bhusang/kicad_footprints/OLIMEX/KiCAD/KiCAD_Footprints/OLIMEX_3Dmodels/rubber_feet.SLDPRT

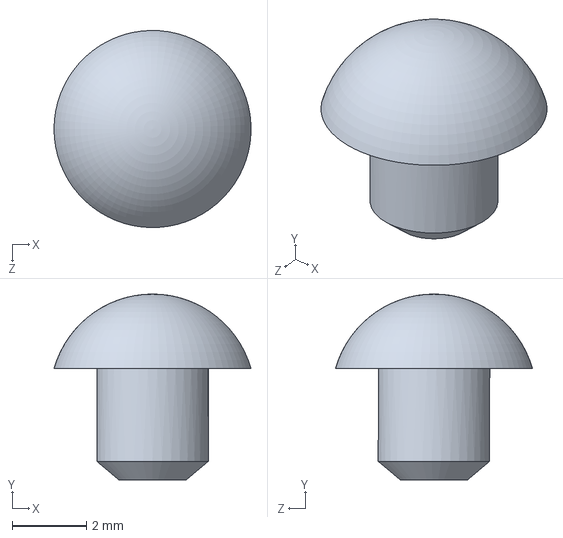
[picture p1: CAD file, 2022-04-01]
OLIMEX/KiCAD/KiCAD_Footprints/OLIMEX_3Dmodels/rubber_feet.SLDPRT
5.30 x 5.00 x 5.30 mm
