bhusang/kicad_footprints/OLIMEX/KiCAD/KiCAD_Footprints/OLIMEX_3Dmodels/User Library-BU2032SM-HD-G(CR2032 Battery Holder).SLDPRT

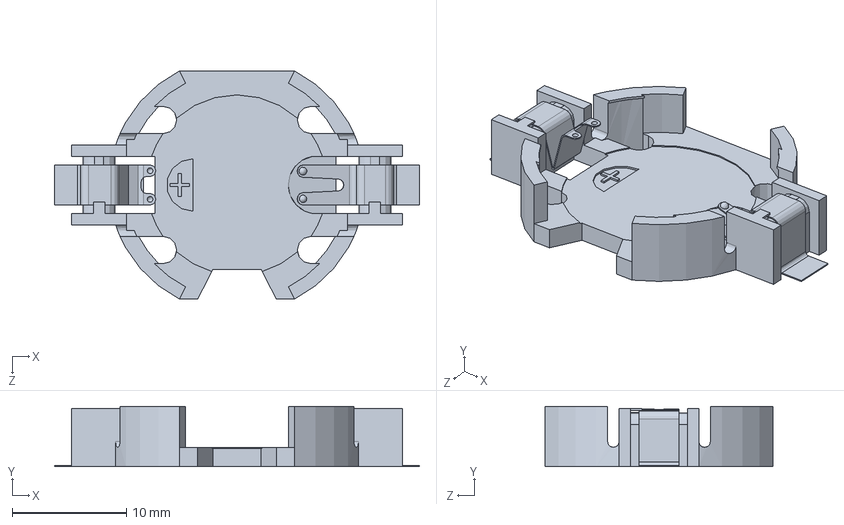
[picture p2: CAD file, 2022-04-01]
OLIMEX/KiCAD/KiCAD_Footprints/OLIMEX_3Dmodels/User Library-BU2032SM-HD-G(CR2032 Battery Holder).SLDPRT
32.0 x 5.30 x 20.0 mm
