bhusang/kicad_footprints/adamgreig/agg-kicad/mod/ic/htqfp-64.yaml

description: HTQFP-64 (LQFP-64 with Exposed PowerPAD)
name: HTQFP-64
rows: 4
pins: 64
pin_pitch: 0.5
row_pitch: 11.4
pad_shape: [1.5, 0.3]
chip_shape: [10.2, 10.2]
pin_shape: [1.0, 0.27]
ep_shape: [8, 8]
ep_paste_shape: [7, 7, 0, 0]
ep_mask_shape: [7, 7, 0, 0]
ep_vais: [0.3, 0.6, 1.3]
model:
  offset: [0, 0, 0]
  rotate: [0, 0, 0]
  scale: [1, 1, 1]
  path: "${KISYS3DMOD}/Housings_QFP.3dshapes/LQFP-64_10x10mm_Pitch0.5mm.wrl"
