bhusang/kicad_footprints/adamgreig/agg-kicad/mod/ic/lattice-sg48.yaml

chip_shape: [7, 7]
description: QFN-48 from Lattice iCE40UP5K SG48
ep_mask_shape: [0.8, 0.8, 0.6, 0.6]
ep_paste_shape: [0.8, 0.8, 0.6, 0.6]
ep_shape: [5.4, 5.4]
ep_vias: [0.4, 0.8, 0.8]
model:
  offset: [0, 0, 0]
  path: ${KISYS3DMOD}/Housings_DFN_QFN.3dshapes/QFN-48-1EP_7x7mm_P0.5mm_EP5.15x5.15mm.step
  rotate: [0, 0, 0]
  scale: [1, 1, 1]
name: Lattice-SG48
pad_shape: [0.7, 0.25]
pin_pitch: 0.5
pin_shape: [-0.4, 0.25]
pins: 48
row_pitch: 6.8
rows: 4
