bhusang/kicad_footprints/adamgreig/agg-kicad/mod/ic/lqfp-100.yaml

chip_shape: [14.2, 14.2]
description: |-
  LQFP-100 from JEDEC MS-026BED
  IPC-7351B: QFP50P1600X1600X160-100N
model:
  offset: [0, 0, 0]
  path: ${KISYS3DMOD}/Housings_QFP.3dshapes/LQFP-100_14x14mm_Pitch0.5mm.wrl
  rotate: [0, 0, 0]
  scale: [1, 1, 1]
name: LQFP-100
pad_shape: [1.5, 0.3]
pin_pitch: 0.5
pin_shape: [1.0, 0.27]
pins: 100
row_pitch: 15.4
rows: 4
