bhusang/kicad_footprints/adamgreig/agg-kicad/mod/ic/lqfp-144.yaml

chip_shape: [20.2, 20.2]
description: |-
  LQFP-144 from JEDEC MS-026BFB
  IPC-7351B: QFP50P2200X2200X160-144N
model:
  offset: [0, 0, 0]
  path: ${KISYS3DMOD}/Housings_QFP.3dshapes/LQFP-144_20x20mm_Pitch0.5mm.wrl
  rotate: [0, 0, 0]
  scale: [1, 1, 1]
name: LQFP-144
pad_shape: [1.5, 0.3]
pin_pitch: 0.5
pin_shape: [1.0, 0.27]
pins: 144
row_pitch: 21.4
rows: 4
