bhusang/kicad_footprints/adamgreig/agg-kicad/mod/ic/lqfp-32.yaml

chip_shape: [7.2, 7.2]
description: LQFP-32 from JEDEC MS-026BBA
model:
  offset: [0, 0, 0]
  path: ${KISYS3DMOD}/Housings_QFP.3dshapes/LQFP-32_7x7mm_Pitch0.8mm.wrl
  rotate: [0, 0, 0]
  scale: [1, 1, 1]
name: LQFP-32
pad_shape: [1.2, 0.5]
pin_pitch: 0.8
pin_shape: [1.0, 0.4]
pins: 32
row_pitch: 8.4
rows: 4
