bhusang/kicad_footprints/adamgreig/agg-kicad/mod/ic/lqfp-64.yaml

chip_shape: [10.2, 10.2]
description: |-
  LQFP-64 from JEDEC MS-026BCD
  IPC-7351B: QFP50P1200X1200X160-64N
model:
  offset: [0, 0, 0]
  path: ${KISYS3DMOD}/Housings_QFP.3dshapes/LQFP-64_10x10mm_Pitch0.5mm.wrl
  rotate: [0, 0, 0]
  scale: [1, 1, 1]
name: LQFP-64
pad_shape: [1.5, 0.3]
pin_pitch: 0.5
pin_shape: [1.0, 0.27]
pins: 64
row_pitch: 11.4
rows: 4
