bhusang/kicad_footprints/adamgreig/agg-kicad/mod/ic/msop-10-ep-ti.yaml

chip_shape: [3.0, 3.0]
description: |-
  MSOP-10 with 0.5mm pin pitch and an EP, TI specific
  For the TPS92512, from its datasheet
  JEDEC MO-187BA-T
  IPC-7351B: SOP50P490X110-11N
ep_mask_shape: [1.83, 1.89, 0, 0]
ep_paste_shape: [1.83, 1.89, 0, 0]
ep_shape: [2.2, 3.1]
ep_vias: [0.3, 0.5, 0.3]
model:
  offset: [0, 0, 0]
  path: ${KISYS3DMOD}/Housings_SSOP.3dshapes/MSOP-10-1EP_3x3mm_Pitch0.5mm.wrl
  rotate: [0, 0, 0]
  scale: [1, 1, 1]
name: MSOP-10-EP-TI
pad_shape: [1.45, 0.3]
pin_pitch: 0.5
pin_shape: [0.95, 0.22]
pins: 10
row_pitch: 4.4
rows: 2
