bhusang/kicad_footprints/adamgreig/agg-kicad/mod/ic/msop-10.yaml

chip_shape: [3.0, 3.0]
description: |-
  MSOP-10 with 0.5mm pin pitch
  JEDEC MO-187
  IPC-7351B: SOP50P490X110-10N
model:
  offset: [0, 0, 0]
  path: ${KISYS3DMOD}/Housings_SSOP.3dshapes/MSOP-10_3x3mm_Pitch0.5mm.wrl
  rotate: [0, 0, 0]
  scale: [1, 1, 1]
name: MSOP-10
pad_shape: [1.45, 0.3]
pin_pitch: 0.5
pin_shape: [0.95, 0.25]
pins: 10
row_pitch: 4.4
rows: 2
