bhusang/kicad_footprints/adamgreig/agg-kicad/mod/ic/qfn-16-ep-ti.yaml

chip_shape: [3.0, 3.0]
description: |-
  VQFN-16 from TPS6215
  IPC-7351B: QFN26P300X300X100-17N
ep_paste_shape: [1.5, 1.5, 0.2, 0.2]
ep_shape: [1.7, 1.7]
ep_vias: [0.2, 0.3, 0.9]
model:
  offset: [0, 0, 0]
  path: ${KISYS3DMOD}/Housings_DFN_QFN.3dshapes/QFN-16-1EP_3x3mm_Pitch0.5mm.wrl
  rotate: [0, 0, 0]
  scale: [1, 1, 1]
name: QFN-16-EP-TI
pad_shape: [0.6, 0.25]
pin_pitch: 0.5
pin_shape: [-0.4, 0.25]
pins: 16
row_pitch: 2.8
rows: 4
