bhusang/kicad_footprints/adamgreig/agg-kicad/mod/ic/qfn-20-ep-si3402-b.yaml

chip_shape: [5.0, 5.0]
description: |-
  QFN-20 from JEDEC MO-220VHHB-1
  For Si3402-B
  IPC-7351B: QFN80P500X500X85-21N
ep_paste_shape: [1.1, 1.1, 0.2, 0.2]
ep_shape: [2.75, 2.75]
model:
  offset: [0, 0, 0]
  path: ${KISYS3DMOD}/Housings_DFN_QFN.3dshapes/QFN-20-1EP_5x5mm_Pitch0.65mm.wrl
  rotate: [0, 0, 0]
  scale: [1, 1, 1]
name: QFN-20-EP-SI3402-B
pad_shape: [0.95, 0.3]
pin_pitch: 0.8
pin_shape: [-0.55, 0.3]
pins: 20
row_pitch: 4.7
rows: 4
