bhusang/kicad_footprints/adamgreig/agg-kicad/mod/ic/qfn-64-ep-ltc-up.yaml

chip_shape: [9.0, 9.0]
description: |-
  QFN-64 from LTC2975 datasheet
  IPC-7351B: QFN50P900X900X75-64N
ep_mask_shape: [0.7, 0.7, 0.6, 0.6]
ep_paste_shape: [0.7, 0.7, 0.6, 0.6]
ep_shape: [7.15, 7.15]
ep_vias: [0.4, 0.8, 0.47]
model:
  offset: [0, 0, 0]
  path: ${KISYS3DMOD}/Housings_DFN_QFN.3dshapes/QFN-64-1EP_9x9mm_Pitch0.5mm.wrl
  rotate: [0, 0, 0]
  scale: [1, 1, 1]
name: QFN-64-EP-LTC-UP
pad_shape: [0.7, 0.25]
pin_pitch: 0.5
pin_shape: [-0.4, 0.25]
pins: 64
row_pitch: 8.8
rows: 4
