bhusang/kicad_footprints/adamgreig/agg-kicad/mod/ic/sc-70-5.yaml

chip_shape: [1.4, 2.15]
description: |-
  SC-70-5
  JEDEC MO-203-AA
  IPC-7351B: SOT65P210X110-5N
model:
  offset: [0, 0, 0]
  path: ${KISYS3DMOD}/TO_SOT_Packages_SMD.3dshapes/SC-70-5.wrl
  rotate: [0, 0, 90]
  scale: [1, 1, 1]
name: SC-70-5
pad_shape: [0.95, 0.4]
pin_pitch: 0.65
pin_shape: [0.5, 0.3]
pins: 6
row_pitch: 2.2
rows: 2
skip_pins: [5]
