bhusang/kicad_footprints/adamgreig/agg-kicad/mod/ic/sot-23-5.yaml

chip_shape: [1.7, 3.0]
description: |-
  SOT-23-5
  JEDEC MO-178
  IPC-7351B: SOT95P280X135-5N
model:
  offset: [0, 0, 0]
  path: ${KISYS3DMOD}/TO_SOT_Packages_SMD.3dshapes/SOT-23-5.wrl
  rotate: [0, 0, 0]
  scale: [1, 1, 1]
name: SOT-23-5
pad_shape: [1.1, 0.6]
pin_pitch: 0.95
pin_shape: [0.75, 0.5]
pins: 6
row_pitch: 2.6
rows: 2
skip_pins: [5]
