bhusang/kicad_footprints/adamgreig/agg-kicad/mod/ic/sot-23-6.yaml

chip_shape: [1.75, 3.05]
description: |-
  SOT-23-6
  JEDEC MO-178AB
  IPC-7351B: SOT95P280X145-6N
model:
  offset: [0, 0, 0]
  path: ${KISYS3DMOD}/TO_SOT_Packages_SMD.3dshapes/SOT-23-6.wrl
  rotate: [0, 0, 0]
  scale: [1, 1, 1]
name: SOT-23-6
pad_shape: [1.1, 0.6]
pin_pitch: 0.95
pin_shape: [0.62, 0.5]
pins: 6
row_pitch: 2.6
rows: 2
