bhusang/kicad_footprints/adamgreig/agg-kicad/mod/ic/ssop-20.yaml

chip_shape: [5.6, 7.2]
description: |-
  SSOP-20 from JEDEC MO-150AE
  IPC-7351B: SOP65P780X200-20N
model:
  offset: [0, 0, 0]
  path: ${KISYS3DMOD}/Housings_SSOP.3dshapes/SSOP-20_5.3x7.2mm_Pitch0.65mm.wrl
  rotate: [0, 0, 0]
  scale: [1, 1, 1]
name: SSOP-20
pad_shape: [1.85, 0.45]
pin_pitch: 0.65
pin_shape: [1.3, 0.38]
pins: 20
row_pitch: 7.0
rows: 2
