bhusang/kicad_footprints/adamgreig/agg-kicad/mod/ic/tssop-16.yaml

chip_shape: [4.5, 5.1]
description: |-
  TSSOP-16 from JEDEC MO-153AB
  IPC-7351B: SOP65P500X120-16N
model:
  offset: [0, 0, 0]
  path: ${KISYS3DMOD}/Housings_SSOP.3dshapes/TSSOP-16_4.4x5mm_Pitch0.65mm.wrl
  rotate: [0, 0, 0]
  scale: [1, 1, 1]
name: TSSOP-16
pad_shape: [1.35, 0.45]
pin_pitch: 0.65
pin_shape: [0.95, 0.3]
pins: 16
row_pitch: 5.75
rows: 2
