bhusang/kicad_footprints/adamgreig/agg-kicad/mod/ic/ufdfn-8.yaml

chip_shape: [3.0, 2.0]
description: |-
  UFDFN-8 / USON-8 from JEDEC MO-220
  AKA Winbond UX
model:
  offset: [0, 0, 0]
  path: ${KISYS3DMOD}/Package_DFN_QFN.3dshapes/DFN-8-1EP_3x2mm_P0.5mm_EP1.75x1.45mm.step
  rotate: [0, 0, 0]
  scale: [1, 1, 1]
name: UFDFN-8
pad_shape: [0.3, 0.25]
pin_pitch: 0.5
pin_shape: [-0.45, 0.25]
pins: 8
row_pitch: 2.45
rows: 2
