bhusang/kicad_footprints/(commit log)

2022-04-01 added as directories not submodules
    [0.8x1.6x0.8mm.step, 0402_1x0.5x0.35_resistor.FCStd, 0402_1x0.5x0.35_resistor.step, 0603_1.6x0.8x0.45_resistor.FCStd, 0603_1.6x0.8x0.45_resistor.step, 0603_led.step, 0603_right_angle.stp, 0805_2x1.25x1_capacitor.step]
2022-04-01 deleted extra files
    [0.8x1.6x0.8mm.step, 0402_1x0.5x0.35_resistor.FCStd, 0402_1x0.5x0.35_resistor.step, 0603_1.6x0.8x0.45_resistor.FCStd, 0603_1.6x0.8x0.45_resistor.step, 0603_led.step, 0603_right_angle.stp, 0805_2x1.25x1_capacitor.step]
